rdalla/proj_kicad_esp32_energy_consumption/README.md

# ESP32 ENERGY MONITORING MODULE

##MAIN COMPONENTS:
- ESP-WROOM-32 (ESP32 WIFI MODULE)
- SCT-013 50A/1V (CURRENT SENSOR 50A - NOT INVASIVE)
