rdalla/proj_kicad_esp32_energy_consumption/BOM_Reference_ESP32_ENERGY_MONITOR.xlsx

Sheet: Project Info
Source: | C:\Users\Usuario\Documents\projetos_git\proj_kicad_esp32_energy_consumption\esp32_energy_monitor.sch
Date: | 2020-08-01 09:51
Tool: | Eeschema (5.1.4)-1
Generator: | C:\Program Files\KiCad\bin\scripting\plugins/bom_csv_grouped_by_value_with_fp.py
Component Count: | 50

Sheet: BOM
Ref | Qnty | Value | Footprint
C3, | 1 | 10uF 6.3V X7R | proj_kicad_esp32_energy_consumption:C_0603
C4, | 1 | 1nF | proj_kicad_esp32_energy_consumption:C_0603
C5, C2, C9, | 3 | 10uF ou 100uF | proj_kicad_esp32_energy_consumption:C_0603
C6, | 1 | 0.1uF XR7 ceramic | proj_kicad_esp32_energy_consumption:C_0603
C10, | 1 | 4.7uF/6.3V | proj_kicad_esp32_energy_consumption:C_0603
C11, C17, C14, C13, C12, C1, | 6 | 0.1uF | proj_kicad_esp32_energy_consumption:C_0603
C18, C8, C7, | 3 | 10uF | proj_kicad_esp32_energy_consumption:C_0603
D1, D3, D2, | 3 | ESD401DPYR | proj_kicad_esp32_energy_consumption:DPY_R-PX1SON-N2_
FB2, FB1, | 2 | MPZ1608S221ATA00 | proj_kicad_esp32_energy_consumption:0603
H1, H2, H3, H4, | 4 | M2Hole | proj_kicad_esp32_energy_consumption:MountingHole_2.2mm_M2_DIN965
IC1, | 1 | TPS63031DSKT | proj_kicad_esp32_energy_consumption:SON50P250X250X80-11N-D
IC2, | 1 | CP2102N-A01-GQFN28 | proj_kicad_esp32_energy_consumption:QFN50P500X500X80-29N-D
J1, | 1 | USB_OTG | proj_kicad_esp32_energy_consumption:USB_Micro_B_Female_1050170001
J3, J2, J4, | 3 | Conn_01x02 | proj_kicad_esp32_energy_consumption:Pin_Header_Straight_1x02_Pitch2.54mm
L1, | 1 | 1.5uH | proj_kicad_esp32_energy_consumption:INDC3030X120N
MOD1, | 1 | ESP32-WROOM-32 | proj_kicad_esp32_energy_consumption:ESP32WROOM32D
Q1, Q2, | 2 | SS8050-G | proj_kicad_esp32_energy_consumption:SOT95P240X115-3N
R3, | 1 | 330R | proj_kicad_esp32_energy_consumption:R_0603
R5, R4, R2, R1, R7, R6, | 6 | 100K/1% | proj_kicad_esp32_energy_consumption:R_0603
R8, R9, R13, | 3 | 10k | proj_kicad_esp32_energy_consumption:R_0603
R10, | 1 | 22.1k | proj_kicad_esp32_energy_consumption:R_0603
R11, | 1 | 47.5k | proj_kicad_esp32_energy_consumption:R_0603
R12, | 1 | 1k | proj_kicad_esp32_energy_consumption:R_0603
SW2, SW1, | 2 | SW_Push | proj_kicad_esp32_energy_consumption:SW_SPST_B3U-1000P
