rdalla/proj_kicad_esp32_energy_consumption/esp32_energy_monitor_gerber_files/BOM_ESP32_ENERGY_MONITOR.xlsx

Sheet: Project Info
Source: | C:\Users\Usuario\Documents\projetos_git\proj_kicad_esp32_energy_consumption\esp32_energy_monitor.sch
Date: | 2020-08-01 09:51
Tool: | Eeschema (5.1.4)-1
Generator: | C:\Program Files\KiCad\bin\scripting\plugins/bom_csv_grouped_by_value_with_fp.py
Component Count: | 43

Sheet: BOM
Reference | Quantity | Part Number | Manufacturer | Footprint
C3, C5, C2, C9, C18, C8, C7 | 7 | CL10B106MQ8NRNC | Samsung | C_0603
C4 | 1 | C0603C102K9RAC7867 | KEMET | C_0603
C6, C11, C17, C14, C13, C12, C1 | 7 | C0603C104K9RAC7867 | KEMET | C_0603
C10 | 1 | CL10B475KQ8NQNC | Samsung | C_0603
D1, D3, D2 | 3 | ESD401DPYR | Texas Instruments | DPY_R-PX1SON-N2_
FB2, FB1 | 2 | MPZ1608S221ATA00 | TDK | 0603
IC1 | 1 | TPS63031DSKT | Texas Instruments | SON50P250X250X80-11N-D
IC2 | 1 | CP2102N-A01-GQFN28 | Silicon Labs | QFN50P500X500X80-29N-D
J1 | 1 | 105017-0001 | Molex | USB_Micro_B_Female_1050170001
L1 | 1 | LQH3NPN1R5MJRL | Murata | INDC3030X120N
MOD1 | 1 | ESP32-WROOM-32D | Espressif | ESP32WROOM32D
Q1, Q2 | 2 | SS8050-G | Comchip | SOT95P240X115-3N
R3 | 1 | CR0603-JW-331ELF | Bourns | R_0603
R5, R4, R2, R1, R7, R6 | 6 | CR0603-JW-104ELF | Bourns | R_0603
R8, R9, R13 | 3 | CR0603-JW-103ELF | Bourns | R_0603
R10 | 1 | CR0603-FX-2212ELF | Bourns | R_0603
R11 | 1 | CR0603-FX-4752ELF | Bourns | R_0603
R12 | 1 | CR0603-JW-102ELF | Bourns | R_0603
SW2, SW1 | 2 | B3U-1000P | Omron | SW_SPST_B3U-1000P
