rdalla/proj_kicad_esp32_energy_consumption/esp32_energy_monitor.kicad_pcb

## KiCad design esp32_energy_monitor.kicad_pcb (2020-08-23)

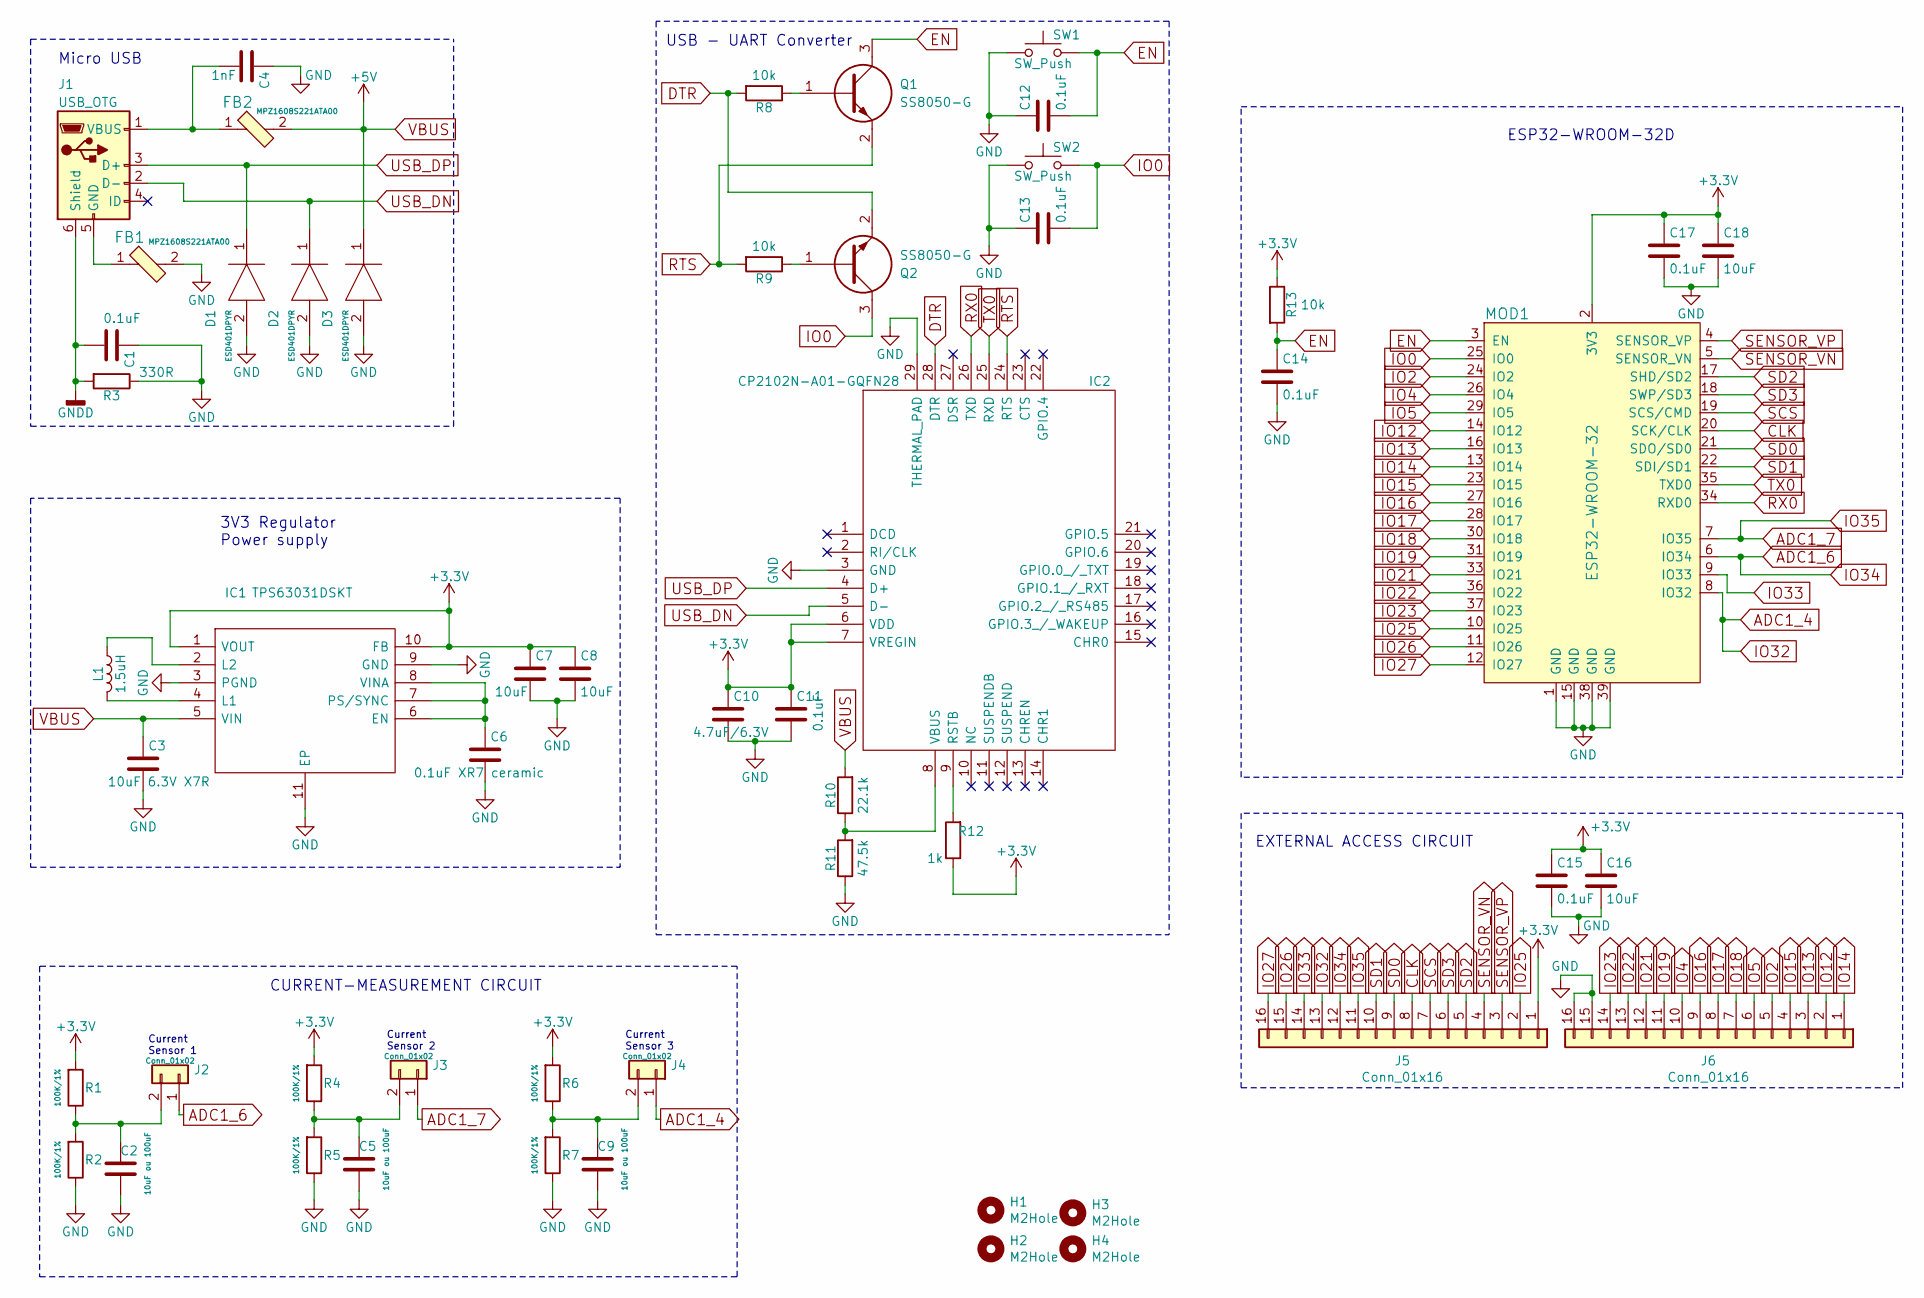
[picture p1: schematic esp32_energy_monitor.sch, ESP32 ENERGY MONITOR]

Parts:
C1, C11, C12, C13, C14, C15, C17: 0.1uF; C_0603
C2, C5, C9: 10uF ou 100uF; C_0603
C3: 10uF 6.3V X7R; C_0603
C4: 1nF; C_0603
C6: 0.1uF XR7 ceramic; C_0603
C7, C8, C16, C18: 10uF; C_0603
C10: 4.7uF/6.3V; C_0603
D1, D2, D3: ESD401DPYR; DPY_R-PX1SON-N2_; Manufacturer_Part_Number ESD401DPYR; Mouser Part Number 595-ESD401DPYR
FB1, FB2: MPZ1608S221ATA00; 0603; MPN MPZ1608S221ATA00; Digi-Key_PN 445-1565-1-ND
H1, H2, H3, H4: M2Hole; MountingHole_2.2mm_M2_DIN965
IC1: TPS63031DSKT; SON50P250X250X80-11N-D; Mouser Part Number 595-TPS63031DSKT
IC2: CP2102N-A01-GQFN28; QFN50P500X500X80-29N-D; Mouser Part Number 634-CP2102NA01GQFN28
J1: USB_OTG; USB_Micro_B_Female_1050170001
J2, J3, J4: Conn_01x02; Pin_Header_Straight_1x02_Pitch2.54mm
J5, J6: Conn_01x16; PinHeader_1x16_P2.54mm_Vertical
L1: 1.5uH; INDC3030X120N
MOD1: ESP32-WROOM-32; ESP32WROOM32D; MPN ESP32-WROOM-32; Digi-Key_PN 1904-1010-1-ND
Q1, Q2: SS8050-G; SOT95P240X115-3N; Mouser Part Number 750-SS8050-G
R1, R2, R4, R5, R6, R7: 100K/1%; R_0603
R3: 330R; R_0603
R8, R9, R13: 10k; R_0603
R10: 22.1k; R_0603
R11: 47.5k; R_0603
R12: 1k; R_0603
SW1, SW2: SW_Push; SW_SPST_B3U-1000P

Connections:
+3V3: C7.1, C8.1, C10.1, C11.1, C15.1, C16.1, C17.1, C18.1, IC1.1 (VOUT), IC1.10 (FB), IC2.6 (VDD), IC2.7 (VREGIN), J5.1, MOD1.2 (3V3), R1.2, R4.2, R6.2, R12.1, R13.1
ADC1_4: J4.1, J5.13, MOD1.8 (IO32)
ADC1_6: J2.1, J5.12, MOD1.6 (IO34)
ADC1_7: J3.1, J5.11, MOD1.7 (IO35)
CLK: J5.8, MOD1.20 (SCK/CLK)
DTR: IC2.28 (DTR), Q2.2, R8.2
EN: C12.2, C14.1, MOD1.3 (EN), Q1.3, R13.2, SW1.2
GND: C1.1, C2.2, C3.2, C4.1, C5.2, C6.2, C7.2, C8.2, C9.2, C10.2, C11.2, C12.1, C13.1, C14.2, C15.2, C16.2, C17.2, C18.2, D1.2, D2.2, D3.2, FB1.2, IC1.3 (PGND), IC1.9 (GND), IC1.11 (EP), IC2.3 (GND), IC2.29 (THERMAL_PAD), J6.15, J6.16, MOD1.1 (GND), MOD1.15 (GND), MOD1.38 (GND), MOD1.39 (GND), R2.1, R3.1, R5.1, R7.1, R11.1, SW1.1, SW2.1
GNDD: C1.2, J1.6 (Shield), J1.SH, R3.2
IO0: C13.2, MOD1.25 (IO0), Q2.3, SW2.2
IO2: J6.5, MOD1.24 (IO2)
IO4: J6.10, MOD1.26 (IO4)
IO5: J6.6, MOD1.29 (IO5)
IO12: J6.2, MOD1.14 (IO12)
IO13: J6.3, MOD1.16 (IO13)
IO14: J6.1, MOD1.13 (IO14)
IO15: J6.4, MOD1.23 (IO15)
IO16: J6.9, MOD1.27 (IO16)
IO17: J6.8, MOD1.28 (IO17)
IO18: J6.7, MOD1.30 (IO18)
IO19: J6.11, MOD1.31 (IO19)
IO21: J6.12, MOD1.33 (IO21)
IO22: J6.13, MOD1.36 (IO22)
IO23: J6.14, MOD1.37 (IO23)
IO25: J5.2, MOD1.10 (IO25)
IO26: J5.15, MOD1.11 (IO26)
IO27: J5.16, MOD1.12 (IO27)
IO33: J5.14, MOD1.9 (IO33)
unnamed: C2.1, J2.2, R1.1, R2.2
unnamed: C4.2, FB2.1, J1.1 (VBUS)
unnamed: C5.1, J3.2, R4.1, R5.2
unnamed: C6.1, IC1.6 (EN), IC1.7 (PS/SYNC), IC1.8 (VINA)
unnamed: C9.1, J4.2, R6.1, R7.2
unnamed: FB1.1, J1.5 (GND)
unnamed: IC1.2 (L2), L1.1
unnamed: IC1.4 (L1), L1.2
unnamed: IC2.8 (VBUS), R10.1, R11.2
unnamed: IC2.9 (RSTB), R12.2
unnamed: Q1.1, R8.1
unnamed: Q2.1, R9.1
RTS: IC2.24 (RTS), Q1.2, R9.2
RX0: IC2.26 (TXD), MOD1.34 (RXD0)
SCS: J5.7, MOD1.19 (SCS/CMD)
SD0: J5.9, MOD1.21 (SDO/SD0)
SD1: J5.10, MOD1.22 (SDI/SD1)
SD2: J5.5, MOD1.17 (SHD/SD2)
SD3: J5.6, MOD1.18 (SWP/SD3)
SENSOR_VN: J5.4, MOD1.5 (SENSOR_VN)
SENSOR_VP: J5.3, MOD1.4 (SENSOR_VP)
TX0: IC2.25 (RXD), MOD1.35 (TXD0)
USB_DN: D2.1, IC2.5 (D-), J1.2 (D-)
USB_DP: D1.1, IC2.4 (D+), J1.3 (D+)
VBUS: C3.1, D3.1, FB2.2, IC1.5 (VIN), R10.2

Notes on the sheet:
Micro USB
3V3 Regulator Power supply
USB - UART Converter
Current Sensor 2
Current Sensor 1
Current Sensor 3
ESP32-WROOM-32D
CURRENT-MEASUREMENT CIRCUIT
EXTERNAL ACCESS CIRCUIT

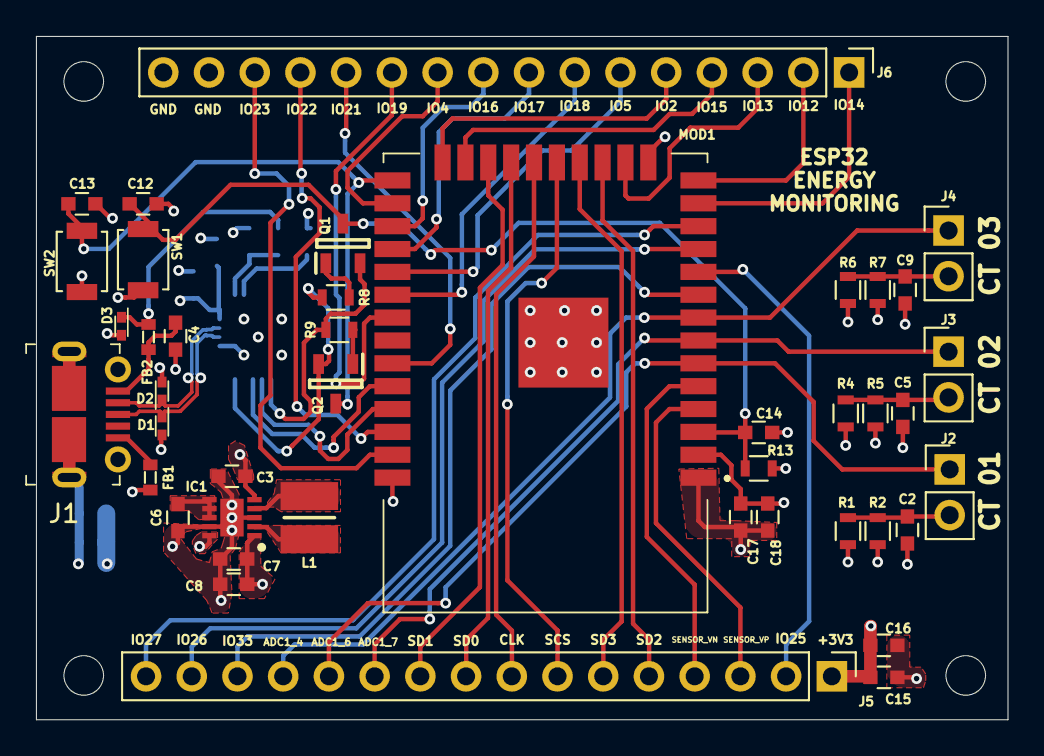
[picture p2: board esp32_energy_monitor.kicad_pcb from above]

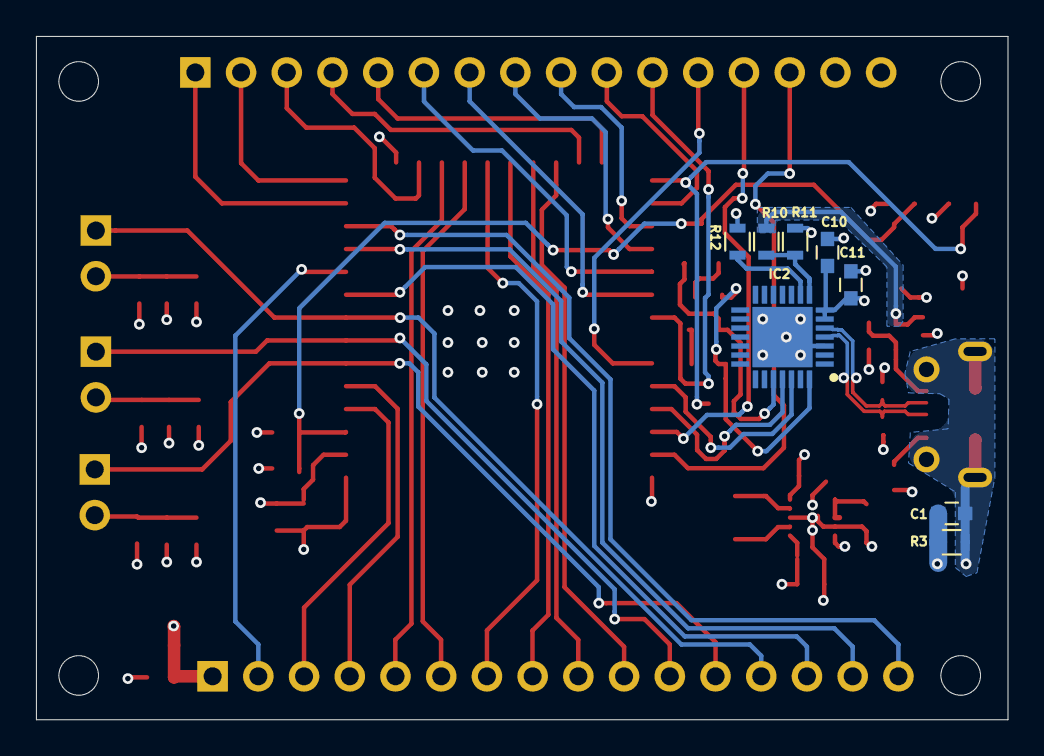
[picture p3: board esp32_energy_monitor.kicad_pcb from below]

Board: 4 copper layers, 54.0 x 38.0 mm, 54 parts (8 on the bottom side), 53 nets.
