rdalla/proj_kicad_esp32_energy_consumption/(commit log)

2020-06-22 Added the first sketch of the schematic. The developed circuits are: - 3V3 Power Supply - TPS63031DSKT - Micro USB Circuit (TVS and filters) - USB to UART Converter - CP2102N - ESP32 basic circuit (b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
    [esp32_energy_monitor.kicad_pcb, esp32_energy_monitor.sch]
2020-06-23 Added the ADS1115IDGSR ADC circuit with the signal conditioning to current sensor SCT-013-020 (30A).
    [esp32_energy_monitor.kicad_pcb, esp32_energy_monitor.sch]
2020-07-27 Schematic: Removed ADS1115 circuit. Removed Battery Protection circuit. Removed Battery Charger circuit. Removed Wake Up Button. Added external access circuit. Added three current measure circuit. It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
    Layout:
    Added the footprint library of the project.
    Changed the ESP32 footprint.
    Changed the position of the power supply circuit. (near of USB connector)
    3D View:
    Added ESP32 3D format step.
    [esp32_energy_monitor.kicad_pcb, esp32_energy_monitor.sch]
2020-07-27 Included all the footprints of the project on the same library "proj_kicad_esp32_energy_consumption".
2020-08-01 Added to the library of the project the pin header footprint.
    Schematic:
    Changed the position of the pins on J5 and J6 to layout better on the board.
    Added all the route tracks of the J5 and J6 connectors
    Added 3V3 Power Plane and the VBUS Power Plane
    Changed the format of the Ground Plane.
    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
    [BOM_ESP32_ENERGY_MONITOR.xlsx, STACKUP_esp32_energy_monitor.xlsx, esp32_energy_monitor.kicad_pcb, esp32_energy_monitor.sch]
2020-08-01 Added to the library of the project the pin header footprint. Added the first version of the Bill of the Materials (BoM) of the board. Added the StackUp of the board.
    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
    [BOM_ESP32_ENERGY_MONITOR.xlsx, STACKUP_esp32_energy_monitor.xlsx, esp32_energy_monitor.kicad_pcb, esp32_energy_monitor.sch]
2020-08-23 Improved the layout of the J5 and J6 to expose all the pins of the ESP32 module.
    Added the Final version of Bill of Materials (BoM).
    Added all the gerber files.
    [BOM_ESP32_ENERGY_MONITOR.xlsx, BOM_Reference_ESP32_ENERGY_MONITOR.xlsx, STACKUP_esp32_energy_monitor.xlsx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]
2020-08-23 Fixed issue in the file kicad_pcb.
    [esp32_energy_monitor.kicad_pcb]
2020-08-23 Fixed the file kicad_pcb.
    [esp32_energy_monitor.kicad_pcb]
